Nxt-1/ESPHome-VictronMP-II-FanController/kicad/VictronMP-II-FanController.kicad_sch

## KiCad design kicad/VictronMP-II-FanController.kicad_sch (2026-08-12)

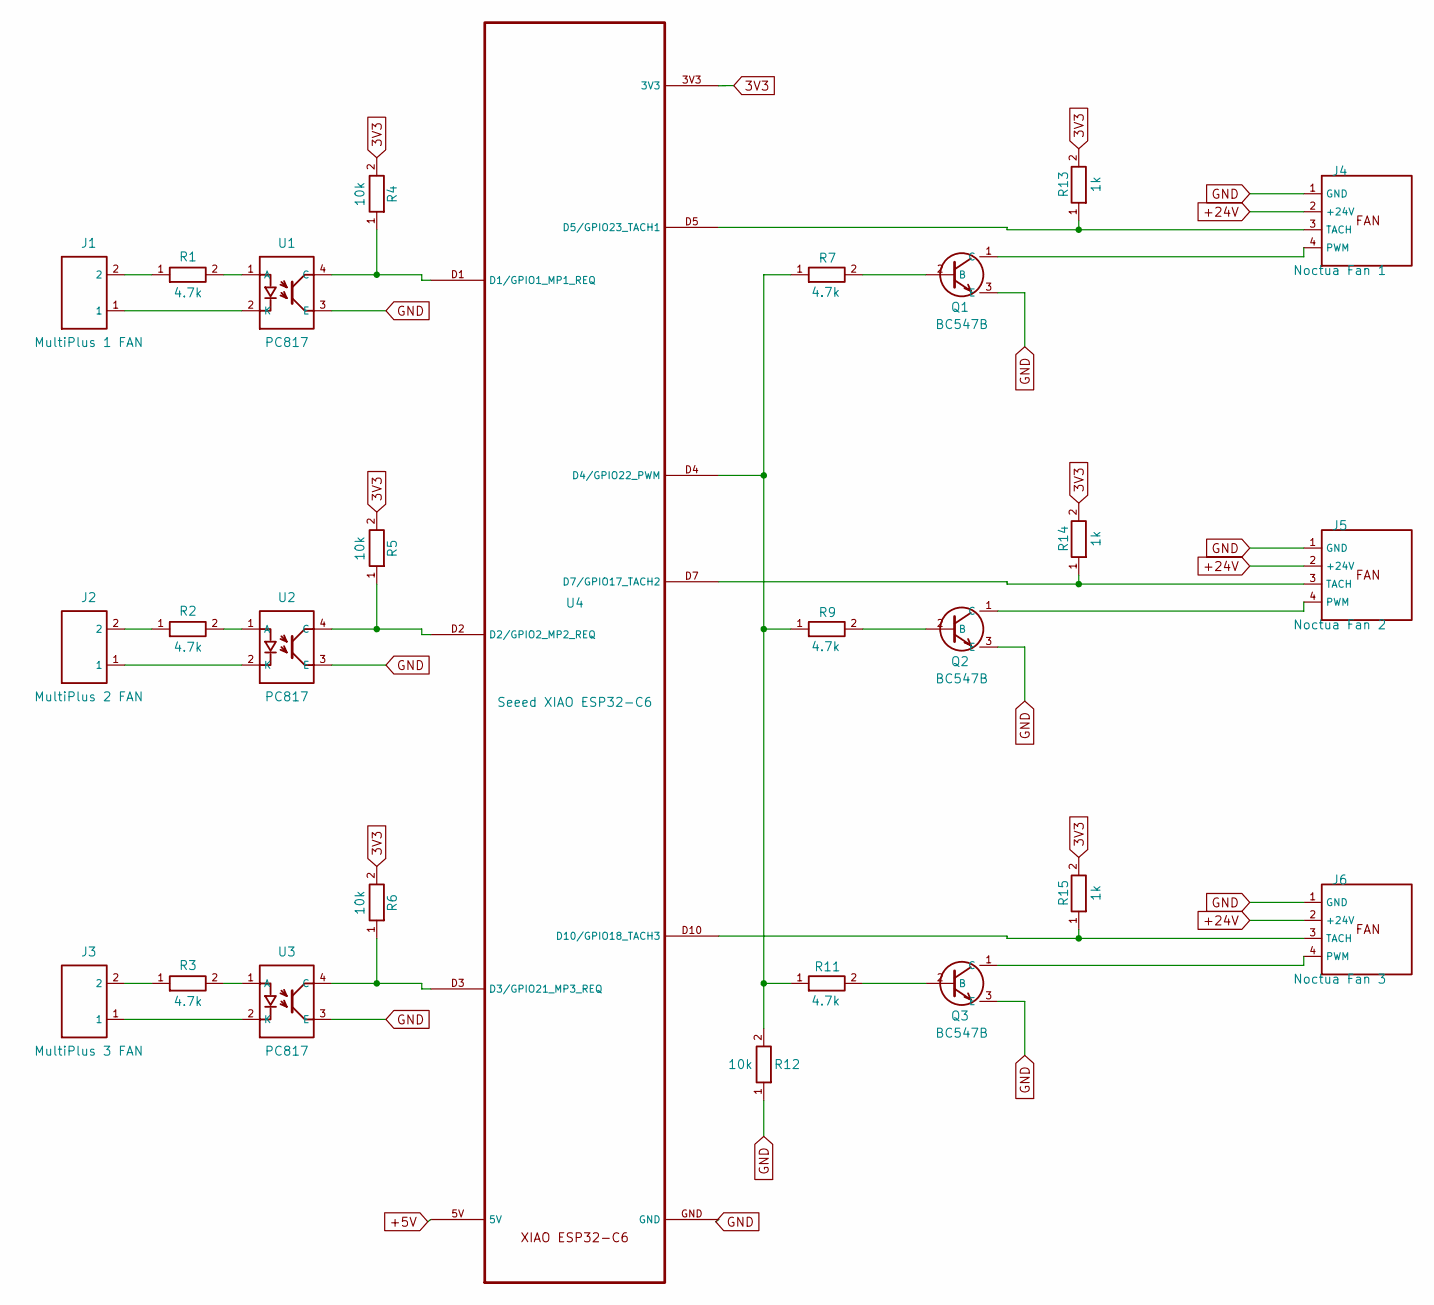
[picture p1: schematic VictronMP-II-FanController.kicad_sch]

Parts:
J1: MultiPlus 1 FAN
J2: MultiPlus 2 FAN
J3: MultiPlus 3 FAN
J4: Noctua Fan 1
J5: Noctua Fan 2
J6: Noctua Fan 3
Q1, Q2, Q3: BC547B; TO-92_Inline
R1, R2, R3, R7, R9, R11: 4.7k; R_Axial_DIN0207_L6.3mm_D2.5mm_P10.16mm_Horizontal
R4, R5, R6, R12: 10k; R_Axial_DIN0207_L6.3mm_D2.5mm_P10.16mm_Horizontal
R13, R14, R15: 1k; R_Axial_DIN0207_L6.3mm_D2.5mm_P10.16mm_Horizontal
U1, U2, U3: PC817; DIP-4_W7.62mm
U4: Seeed XIAO ESP32-C6

Connections:
3V3: R4.2, R5.2, R6.2, R13.2, R14.2, R15.2, U4.3V3
+5V: U4.5V
+24V: J4.2 (+24V), J5.2 (+24V), J6.2 (+24V)
GND: J4.1 (GND), J5.1 (GND), J6.1 (GND), Q1.3 (E), Q2.3 (E), Q3.3 (E), R12.1, U1.3 (E), U2.3 (E), U3.3 (E), U4.GND
unnamed: J1.1, U1.2 (K)
unnamed: J1.2, R1.1
unnamed: J2.1, U2.2 (K)
unnamed: J2.2, R2.1
unnamed: J3.1, U3.2 (K)
unnamed: J3.2, R3.1
unnamed: J4.3 (TACH), R13.1, U4.D5 (D5/GPIO23_TACH1)
unnamed: J4.4 (PWM), Q1.1 (C)
unnamed: J5.3 (TACH), R14.1, U4.D7 (D7/GPIO17_TACH2)
unnamed: J5.4 (PWM), Q2.1 (C)
unnamed: J6.3 (TACH), R15.1, U4.D10 (D10/GPIO18_TACH3)
unnamed: J6.4 (PWM), Q3.1 (C)
unnamed: Q1.2 (B), R7.2
unnamed: Q2.2 (B), R9.2
unnamed: Q3.2 (B), R11.2
unnamed: R1.2, U1.1 (A)
unnamed: R2.2, U2.1 (A)
unnamed: R3.2, U3.1 (A)
unnamed: R4.1, U1.4 (C), U4.D1 (D1/GPIO1_MP1_REQ)
unnamed: R5.1, U2.4 (C), U4.D2 (D2/GPIO2_MP2_REQ)
unnamed: R6.1, U3.4 (C), U4.D3 (D3/GPIO21_MP3_REQ)
unnamed: R7.1, R9.1, R11.1, R12.2, U4.D4 (D4/GPIO22_PWM)
