Nxt-1/ESPHome-VictronMP-II-FanController/(commit log)

2026-08-11 Corrected project URL
    [victron-fan-controller.yaml]
2026-08-11 Fixed .state issue
    [controller.yaml]
2026-08-11 OTa logging added
    [controller.yaml]
2026-08-11 Fixed incorrect board spec
    [controller.yaml]
2026-08-11 Enabled internal pulls for disconnected MP's
    [controller.yaml]
2026-08-12 Added KiCAD
    [VictronMP-II-FanController.kicad_sch]
2026-08-12 Adjusted resistors in schematic
    [VictronMP-II-FanController.kicad_sch]
2026-08-14 Updated controller logic
    [controller.yaml]
